Hocus-Pocus/Morgan-BPEM488CW/README.md

# Morgan-BPEM488CW Schematics and misc files for the BPEM488CW installation on a 2001 Dodge 2500
