Hocus-Pocus/Morgan-BPEM488CW/Test Engine/C135 PCM pinouts.xls

C135 PCM pinouts
Pin | Cct | Gua | Colour | Function
1 | K1 | 18 | DG/RD | MAP sensor signal | Connect to breakout board
2 | K2 | 18 | TN/BK | Coolant temp sensor signal | Connect to breakout board
3 | A14 | 16 | RD/WT | Fused B+ PDC F8 20 amp (hot) | Connect to breakout board
4 | K4 | 20 | BK/LB | Sensor ground | Connect to breakout board
5 | N/C
6 | K6 | 20 | VT/WT | 5V output | Connect to breakout board
7 | K7 | 20 | OR | 8V supply | Connect to breakout board
8 | N/C
9 | F18 | 20 | LG/BK | Ign switch (start/run) fuse block F9 10 amp | Connect to breakout board
10 | T6 | 20 | OR/WT | Trans OD switch output | Delete
11 | Z12 | 16 | BK/TN | Ground | Connect to breakout board
12 | Z12 | 16 | BK/TN | Ground | Connect to breakout board
13 | K113 | 20 | LB/BR | Injectors 5&8 driver | Connect to breakout board
14 | K114 | 20 | Yl/WT | Injectors 3&6 driver | Connect to breakout board
15 | K115 | 20 | TN | Injectors 4&9 driver | Connect to breakout board
16 | K116 | 20 | WT/DB | Injectors 1&10 driver | Connect to breakout board
17 | K18 | 18 | RD/YL | Ignition 8&9 driver | Connect to breakout board
18 | K43 | 20 | DG/GY | Ignition 2&3 driver | Connect to breakout board
19 | K19 | 20 | BK/GY | Ignition 1&6 driver | Connect to breakout board
20 | K20 | 18 | DG | Generator field control | Connect to breakout board
21 | K21 | 16 | BK/RD | Intake Air temp sensor signal | Connect to breakout board
22 | K22 | 18 | OR/DB | Throttle position sensor | Connect to breakout board
23 | K141 | 18 | TN/WT | Left HEGO sensor | Connect to breakout board
24 | K24 | 20 | GY/BK | Crankshaft position sensor | Connect to breakout board
25 | D21 | 20 | PK | SCI transmit | Delete
26 | N/C
27 | C20 | 18 | BR | A/C request signal | Delete
28 | N/C
29 | V40 | 20 | WT/PK | Stop lamp switch output | Delete
30 | T41 | 20 | BK/WT | Park/Neutral switch sense | Delete
31 | T18 | 20 | LG/OR | Transmission OD lamp | Delete
32 | G3 | 20 | BK/PK | Malfunction indicator lamp | Delete
33 | V36 | 20 | TN/RD | Vehicle speed control vacuum signal | Delete
34 | C13 | 20 | DB/OR | A/C compressor clutch relay control | Delete
35 | K35 | 20 | GY/YL | EGR solenoid control | Delete
36 | G14 | 18 | PK/BK | Transmission temp lamp | Delete
37 | K137 | 20 | WT/BK | Dwell signal | Keep stock connection
38 | K138 | 20 | BR/OR | Dwell signal | Keep stock connection
39 | K39 | 18 | GY/RD | Idle air control motor driver | Connect to breakout board
40 | K40 | 18 | BR/WT | Idle air control motor driver | Connect to breakout board
41 | K41 | 18 | BK/DG | Right HEGO sensor | Connect to breakout board
42 | T54 | 18 | VT | Transmission temp signal | Delete
43 | G21 | 20 | GY/LB | Tachometer signal | Connect to breakout board
44 | K44 | 18 | TN/YL | Camshaft position sensor | Connect to breakout board
45 | D20 | 20 | LG | SCI receive | Delete
46 | N/C
47 | G7 | 20 | WT/OR | Vehicle speed sensor signal | Delete
48 | V31 | 20 | BR/RD | VSC switch - set | Delete
49 | V32 | 20 | Yl/RD | VSC switch output (on) | Delete
50 | V33 | 20 | WT/LG | VSC switch resume/accel | Delete
51 | K51 | 20 | DB/YL | ASD/fuel pump relay control | Connect to breakout board
52 | K52 | 20 | PK/BK | Evap/purge solenoid control | Delete
53 | V35 | 20 | LG/RD | Vehicle speed control vent signal | Delete
54 | K54 | 20 | OR/BK | TCC solenoid control | Delete
55 | T60 | 20 | BR | Overdrive solenoid control | Delete
56 | G24 | 20 | GY/PK | Service reminder indicator driver | Delete
57 | A142 | 16 | DG/OR | ASD relay output | Connect to breakout board
58 | K158 | 20 | LG/BK | Injector 2&7 driver | Connect to breakout board
59 | K59 | 18 | VT/BK | Idle air control motor driver | Connect to breakout board
60 | K60 | 18 | YL/BK | Idle air control motor driver | Connect to breakout board
C137 Ignition module
Pin | Cct | Gua | Colour | Function
1 | K32 | 18 | YL/GY | Ignition 4&7 driver | Tap splice to driver board
2 | N/C
3 | N/C
4 | N/C
5 | K17 | 18 | DB/TN | Ignition 5&10 driver | Tap splice to driver board
6 | Z12 | 18 | BK/TN | Ground | Keep stock connection
7 | K138 | 20 | BR/OR | Dwell signal | Keep stock connection
8 | K137 | 20 | WT/BK | Dwell signal | Keep stock connection
9 | F18 | 20 | LG/BK | Ign switch (start/run) fuse block F9 10 amp | Keep stock connection
10 | K7 | 18 | OR | 8V supply | Keep stock connection
