Hocus-Pocus/Morgan-BPEM488CW/Test Engine/Connectors.xls

Test engine connectioins
C125 Grey
C126 Dark Grey
C127 Black
C128 Black
C125 Main harness
Pin | Cct | Gua | Colour | Description
1 | Z11 | 16 | BK/WT | Ground | Connect to fuel pump ground from C128
2 | T41 | 22 | BK/WT | Engine start motor control | C125 Engine harness
3 | T18 | 22 | LG/OR | Trans OD lamp | Delete
4 | T6 | 22 | OR/WT | Trans OD control | Delete
5 | C90 | 18 | LG/OR | A/C high prs switch | Delete
6 | A142 | 14 | DG/OR | ASD output | C125 Engine harness
7 | C13 | 22 | DB/OR | A/C clutch relay control | C125 Engine harness
8 | K51 | 22 | DB/YL | ASD/Fuel pump control | C125 Engine harness
9 | V40 | 22 | WT/PK | Stop lamp switch output | Delete
10 | T40 | 12 | BR | Engine start motor relay output | C125 Engine harness
C126 Main harness
Pin | Cct | Gua | Colour | Description
1 | A14 | 16 | RD/WT | PDC fuse 8 20 amp to PCM (hot all time) | C126 Engine harness
2 | V33 | 20 | WT/LG | Vehicle speed resume | Delete
3 | V32 | 20 | YL/RD | Vehicle speed control to PCM | Delete
4 | V31 | 20 | BR/RD | Vehicle speed set | Delete
5 | F18 | 18 | LG/BK | A/C clutch relay control (not used) | C126 Engine harness
6 | L1 | 18 | VT/BK | Park/Neut-Back up switch | Delete
7 | V35 | 20 | LG/RD | Vehicle speed vent | Delete
8 | G3 | 22 | BK/PK | MIL | Delete
9 | V36 | 20 | TN/RD | Vehicle speed vacuum | Delete
10 | L10 | 18 | BR/LG | Power for back up lamp or park/neut switch | Delete
C127 Main harness
Pin | Cct | Gua | Colour | Description
1 | G85 | 18 | OR/BK | Wait to start | Delete
2 | G21 | 22 | GY/LB | Tachometer | Connect to instrument cluster
3 | G24 | 22 | GY/PK | SRI | Delete
4 | G60 | 22 | GY/YL | Oil pressure guage | Connect to instrument cluster
5 | G60 | 22 | GY | Low oil pressure lamp | Connect to instrument cluster
6 | G20 | 20 | VT/YL | Coolant temperature | Connect to instrument cluster
7 | C3 | 18 | DB/BK | A/C clutch relay output (not used) | C127 Engine harness
8 | G14 | 18 | PK/BK | Trans warning | Delete
9 | G7 | 22 | WT/OR | Vehicle speedometer | Delete
10 | G86 | 18 | TN/OR | Water in fuel | Delete
11 | D21 | 20 | PK/DB | SCI transmit (twisted pair) | Delete
12 | D20 | 20 | DG | SCI receive (twisted pair) | Delete
C128
Pin | Cct | Gua | Colour | Description
1 | L7 | 18 | BK/YL | Tail lamps | Delete
2 | B113 | 20 | RD/VT | Rear wheel ABS sensor (twisted pair) | Delete
3 | L63 | 18 | DG/RD | Left rear signal light | Delete
4 | L62 | 18 | BR/PK | Right rear signal light | Delete
5 | A61 | 16 | DG/BK | Fuel pump relay out | C128 fuel pump harness
6 | Z13 | 16 | BK | Fuel pump ground | Connect to battery ground pig tail
7 | Z11 | 12 | BK/WT | Fuel guage sensor ground | Connect to C125 16 BK/WT (Gnd)
8 | B114 | 20 | WT/VT | Rear wheel ABS sensor (twisted pair) | Delete
9 | G4 | 22 | DB | Fuel guage sensor | Connect to instrument cluster
10 | L1 | 18 | VT/BK | Back up lights | Delete
C215 Instrument Cluster
Pin | Cct | Gua | Colour | Description
1 | G19 | 22 | LG/RD | Anti-Lock troublevindicator | Delete
2 | G107 | 20 | BK/GY | 4WD engaged indicator | Delete
3 |  |  |  | N/C
4 | G4 | 22 | DB | Fuel guage | Connect to C128
5 | G60 | 22 | GY/YL | Oil pressure guage | Connect to C127 Engine harness
6 | Z11 | 20 | BK/WT | Ground | Connect to C125 16 BK/WT (Gnd)
7 | F14 | 20 | LG/YL | Instrument power (hot start/run) | Connect to fuse block F12 15 amp
8 | G29 | 22 | BK/TN | Low washer fluid indicator | Delete
9 | G3 | 22 | BK/PK | Malfunction indicator | Delete
10 | G24 | 22 | GY/PK | Maintenance required indicator | Delete
11 | G60 | 22 | GY | Low oil pressure indicator | Connect to C127 Engine harness
12 | G21 | 22 | GY/LB | Tachometer | Connect to C127 Engine harness
13 |  |  |  | N/C
14 | E2 | 22 | OR | Instrument illumination | Delete
C216 Instrument Cluster
Pin | Cct | Gua | Colour | Description
1 | L60 | 20 | TN/BK | Signal indicator | Delete
2 | G34 | 18 | RD/GY | High beam indicator | Delete
3 | L61 | 20 | LG/YL | Signal indicator | Delete
4 | G7 | 20 | Wt/OR | Speedometer | Connect to volt/frequ generator output
5 | G60 | 22 | GY/YL | Oil pressure guage | Connect to C127 Engine harness
6 | R41 | 18 | BK/TN | Air bag indicator | Delete
7 |  |  |  | N/C
8 | G20 | 22 | VT/YL | Coolant temperature | Connect to C127 Engine harness
9 | Z11 | 20 | BK/WT | Ground | Connect to C125 16 BK/WT (Gnd)
10 | G11 | 22 | WT/BK | Park brake light ground | Delete
11 | G9 | 22 | GY/BK | Brake indicator | Delete
12 | G54 | 22 | OR/BK | Upshift indicator | Delete
13 |  |  |  | N/C
14 | G13 | 20 | DB/RD | Seat belt indicator | Delete
PDC
 | A41 | 14 | YL (YL/RD) | Start relay coil + | Connect load side start button
 | F18 | 20 | LG/BK | ASD/FP/AC coil + from ign switch | Connect to fuse block F18 18 LG/BK
 | A1 | 12 | RD | F3 40 amp master power | Connect to line side ign switch,
 |  |  |  |  | start button and fuse block A31 12 BK/WT
Fuse Block
 | A21 | 12 | DB | Run fuse bus | Connect to load side ign switch
 | F18 | 18 | LG/BK | F9 10 amp | Connect to PDC F18 20 LG/BK
 | V34 | 22 | DB/WT | F10 2 amp | Insulate (spare)
 | F12 | 22 | DB/WT | F11 10 amp | Insulate (spare)
 | F14 | 18 | LG/YL | F12 15 amp | Connect to Inst Clust F14 20 LG/YL
 | A31 | 12 | BK/WT | Hot fuse bus | Connect to PDC A1 12 RD
 | F30 | 18 | RD/OR | F5 20 amp | Insulate (spare)
 | X12 | 18 | RD/WT | F7 10 amp | Insulate (spare)
 | V6 | 16 | DB/BK | F8 20 amp | Insulate (spare)
