Hocus-Pocus/Morgan-BPEM488CW/Test Engine/Test engine data.xls

Test engine data 11/25/20
Engine has dead miss on one or more cylinders
Ignition seems good
Compression warm
1 | 155
3 | 170
5 | 175
7 | 172
9 | 162
2 | 170
4 | 165
6 | 175
8 | 160
10 | 172
Exhaust temp no load
1 | 356
3 | 353
5 | 243
7 | 207
9 | 372
2 | 375
4 | 290
6 | 381
8 | 410
10 | 407
Injector pairs
5&8
3&6
4&9
2&7
11/26/20
Removed injectors, tested, #s 5&7 pintles stuck shut. Squirted carb cleaner into inlet and banged them on the table
Cured. Cleaned all injectorss and fuel rail, fair amount of crap but all others were working
Re-installed. Engine runs probably as good as it can. #4 exhaust temp a bit low. Idle has a bit more "roll"
than I thought it should, but all in all quite good enough for the purpose. Brought up to ~200F and shut it down.
Will check for coolant loss.
Compression warm 09/07/21
1 | 160
3 | 170
5 | 170
7 | 170
9 | 165
2 | 171
4 | 165
6 | 172
8 | 162
10 | 169
Still has a miss. 1 and 4 low exhaust temps, dark plugs. High crankcase vacuum. Runs as well as can be expected
Suspect intake manifold to lifter valley leaks at 1 and 4. High idle with IAC valve closed
